frin-bot/pokemon-fire-red-was-released-onine/(commit log)

2026-05-17 docs: add complete wiring diagram
2026-05-17 docs: add pixel wiring diagram image
2026-05-17 docs: show wiring diagram in readme
2026-05-18 docs: troubleshoot duplicate Arduino library builds
2026-05-18 feat: add Arduino manual input diagnostics
2026-05-18 docs: document Micro Switch VID PID setup
2026-05-19 fix: register Micro controller during setup
    [micro_controller.ino]
2026-05-20 fix: register Micro as HORI controller
    [micro_controller.ino]
2026-05-21 fix: avoid accepting starter nickname prompt
    [micro_controller.ino, test_micro_controller_sequence.py]
2026-05-21 feat: add manual soft reset command
    [micro_controller.ino, test_micro_controller_sequence.py]
2026-05-21 test: document non-shiny reset loop
    [test_hunt_loop_contract.py]
2026-05-21 fix: open starter summary for shiny check
    [micro_controller.ino, test_micro_controller_sequence.py]
2026-05-21 fix: clear rival dialogue before shiny check
    [micro_controller.ino, test_micro_controller_sequence.py]
2026-05-21 feat: capture calibration frames from CLI
2026-05-22 fix: require controller serial acknowledgements
    [cli.py, serial_link.py, test_cli_controller_command.py, test_serial_link.py]
2026-05-22 fix: wait for Nano serial reset
    [cli.py, serial_link.py, test_serial_link.py]
2026-05-22 fix: wait for summary ready before capture
    [serial_link.py, test_serial_link.py]
